technorama-inside/you-decide/README.md

# You Decide
An Exhibition on decisions and how to save the world.

## 01 System
Here you find the information and materials on the construciton system used througout the exhibition.

## 02 Exhibiton
Here you find general information and materials on the exhibition "You Decide". 

## 03 Exhibits
Here you find information and materials for the single exhibits.

# Licencing
All Information and Materials are provided under the following licencses:

Media, Labels and Fonts are licensed under 

Software is licensed under 

Hardware is licensed under 
