technorama-inside/you-decide/02 exhibition/README.md

# Exhibition
Here you find genearl information and materials on the exhibition.
