technorama-inside/you-decide/01 system/README.md

# System
Construction system with elements and connectors
