technorama-inside/you-decide/01 system/03 connectors/main connector.stp

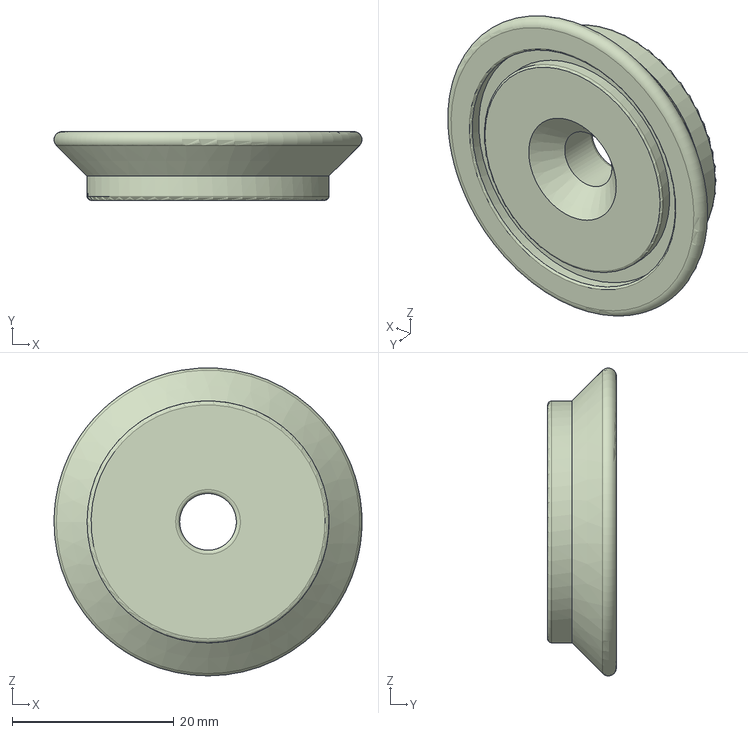
[picture p7: CAD file, 2025-06-03]
01 system/03 connectors/main connector.stp
38.1 x 8.50 x 38.0 mm
