technorama-inside/you-decide/03 exhibits/Click Click Click/03 hardware/click click click_assembly.stp

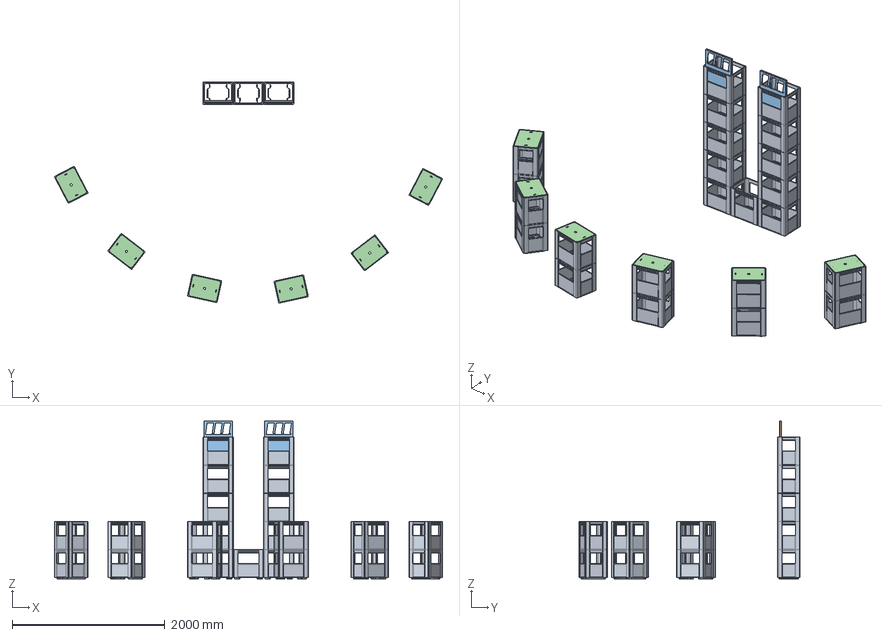
[picture p8: CAD file, 2025-06-03]
03 exhibits/Click Click Click/03 hardware/click click click_assembly.stp
5085.2 x 2898.9 x 2065.3 mm
241209_Harasse_001 x 23
241127_001_Grundplatte Nummer Anzeige x 2
241127_001_Grundplatte Nummer Anzeige_Front x 2
250124_Abdeckplatte Druckknopf_Holz_002 x 6
