technorama-inside/you-decide/03 exhibits/Traffic Light Entrance/03 hardware/traffif light_assembly.stp

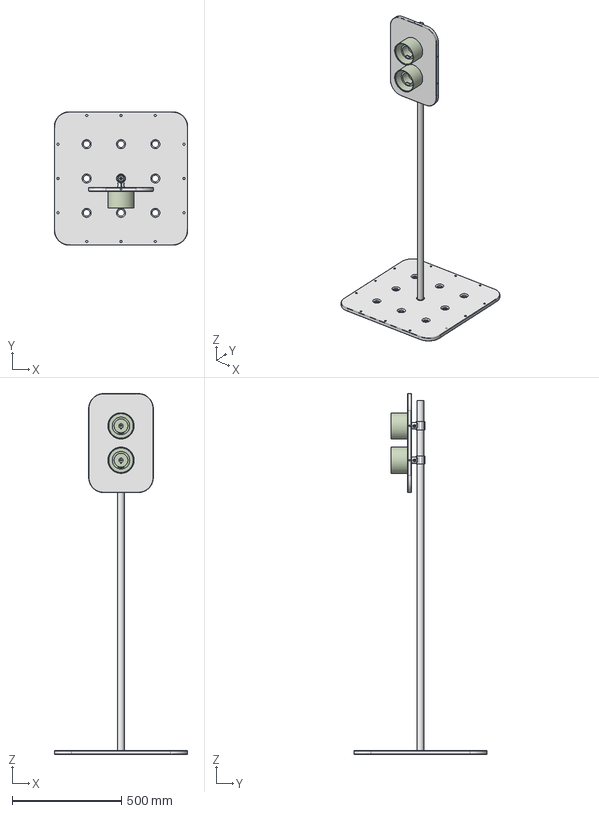
[picture p10: CAD file, 2025-06-04]
03 exhibits/Traffic Light Entrance/03 hardware/traffif light_assembly.stp
610.0 x 610.0 x 1650.0 mm
60x60_005
30x45_005
Verbinder_006_Kabel x 3
250430_Item Rohr Ampel
Verbinder_006 x 2
item_0069044_Verbinder D30 innen Anschluss M6-12_1 x 2
item_0063061_Rohradapter D30_1 x 2
