technorama-inside/you-decide/01 system/02 elements/crate cover.stp

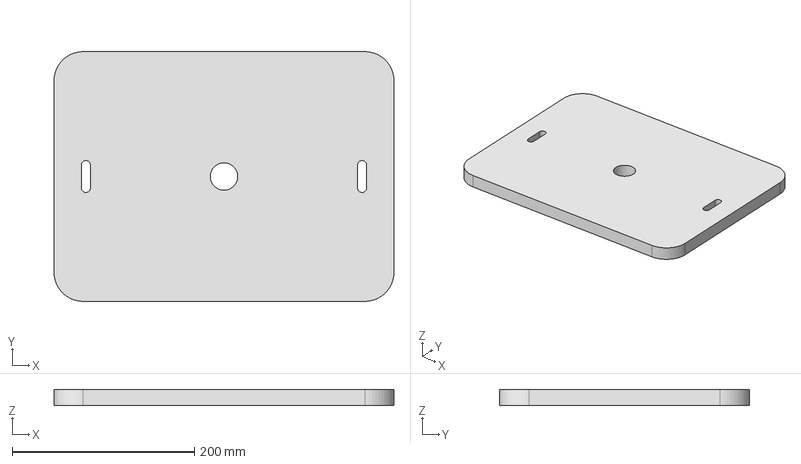
[picture p11: CAD file, 2025-06-03]
01 system/02 elements/crate cover.stp
373.0 x 274.0 x 18.0 mm
