technorama-inside/you-decide/01 system/02 elements/system plate 240 x 120.stp

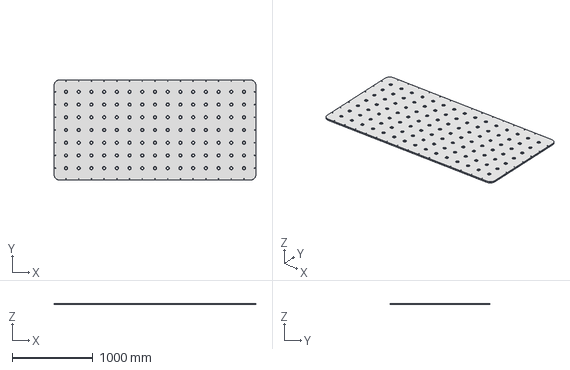
[picture p12: CAD file, 2025-06-03]
01 system/02 elements/system plate 240 x 120.stp
2494.0 x 1238.0 x 18.0 mm
