technorama-inside/you-decide/01 system/02 elements/drilling jig plate system.stp

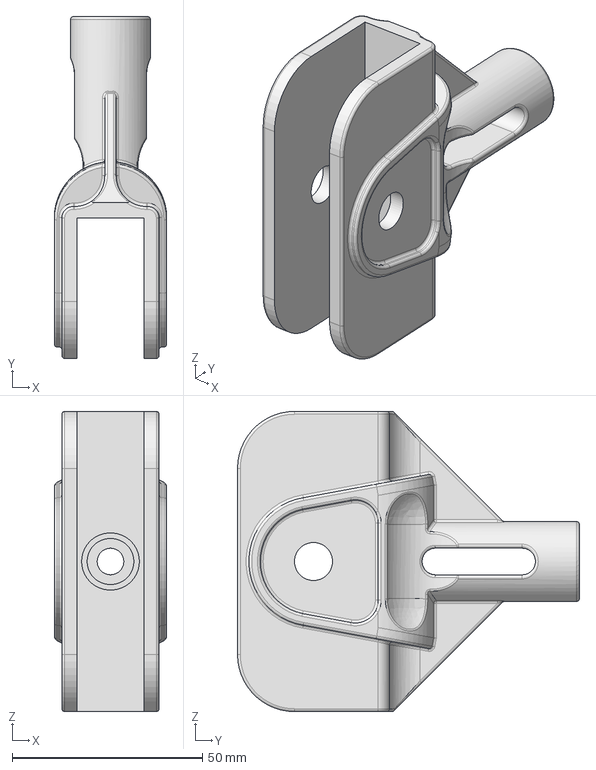
[picture p13: CAD file, 2025-06-03]
01 system/02 elements/drilling jig plate system.stp
29.6 x 90.0 x 79.0 mm
