technorama-inside/you-decide/01 system/01 docs/Core System_You Decide.pdf

2025

## You Decide

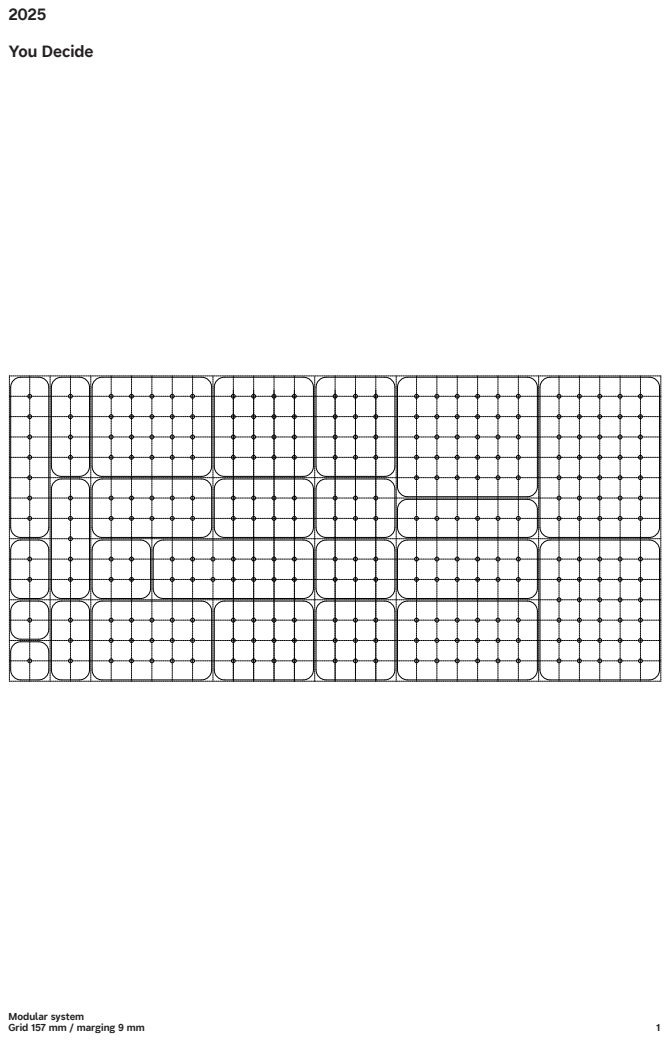
[picture p14: page 1]
Modular system; Grid 157 mm / marging 9 mm

2025

## You Decide

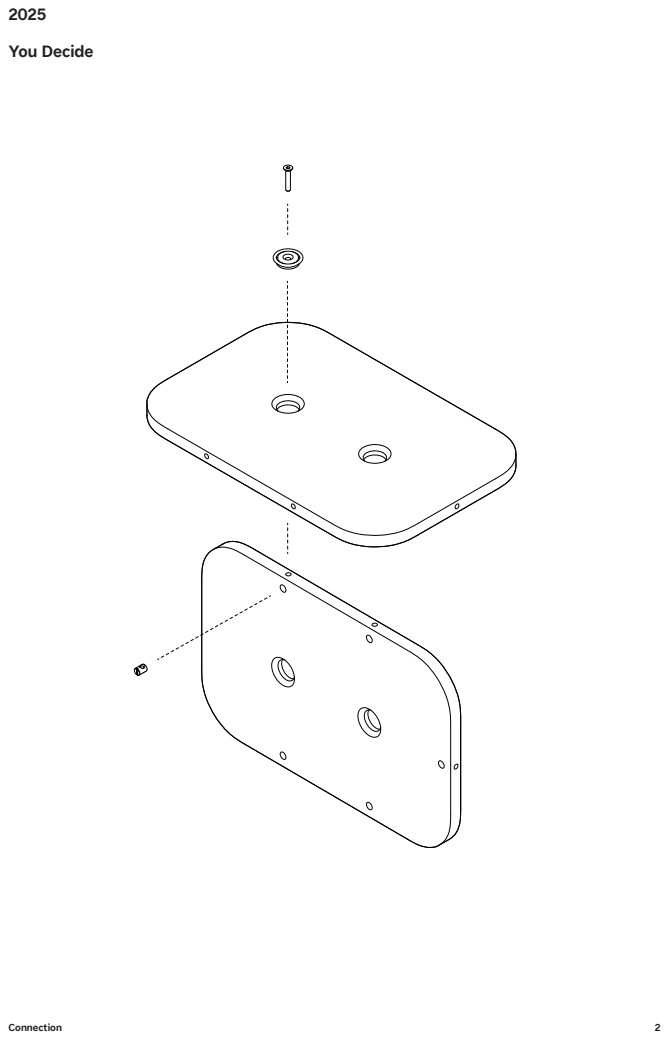
[picture p15: page 2]
Connection
